dasaweb/bsms-keyboard-boss/Fotos_web/1ac2ef55-5758-45f8-84bb-78c7f2ab67ff.jpg

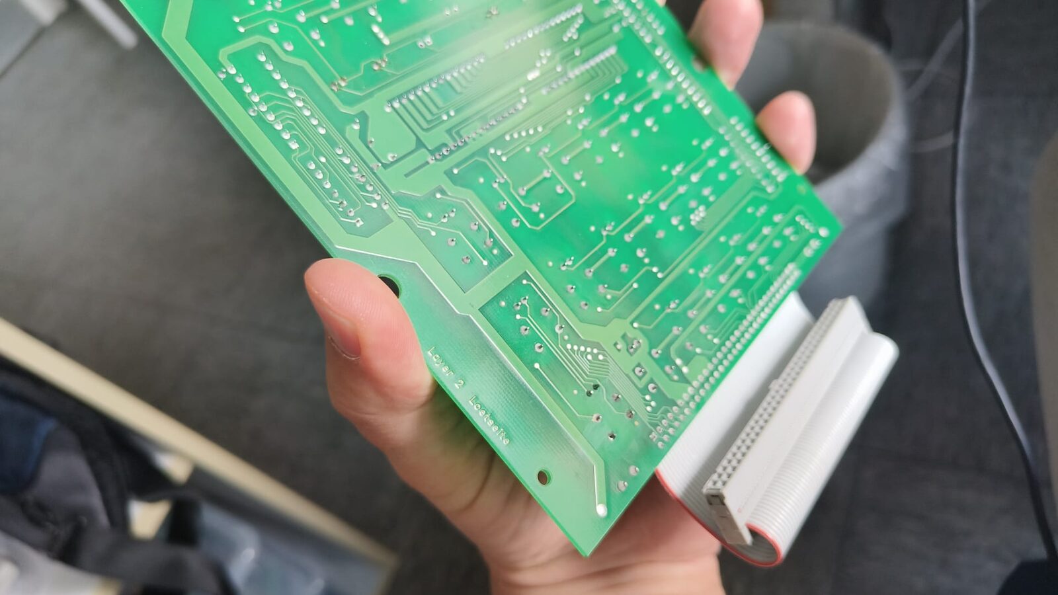
Fotos_web/1ac2ef55-5758-45f8-84bb-78c7f2ab67ff.jpg
