dasaweb/bsms-keyboard-boss/Fotos_web/9411572f-5840-410c-b5de-231dd120ea05.jpg

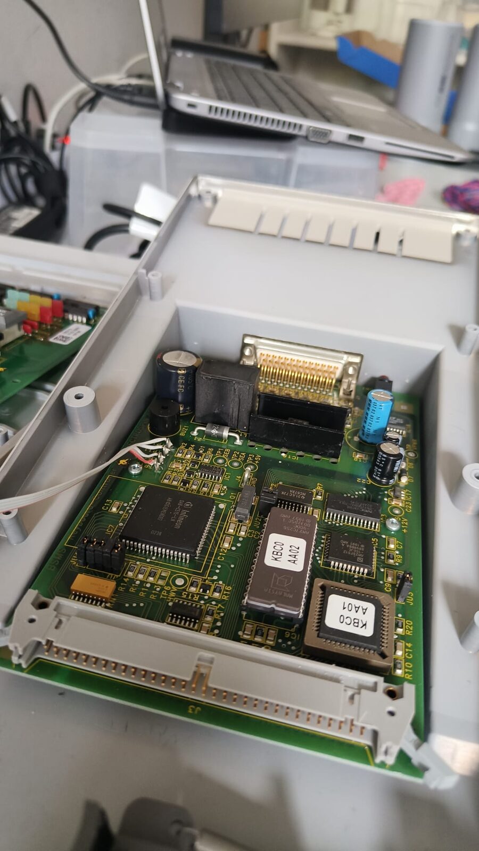
Fotos_web/9411572f-5840-410c-b5de-231dd120ea05.jpg
