dasaweb/bsms-keyboard-boss/Fotos_web/09424705-de8c-4f96-9400-b07d579664a1.jpg

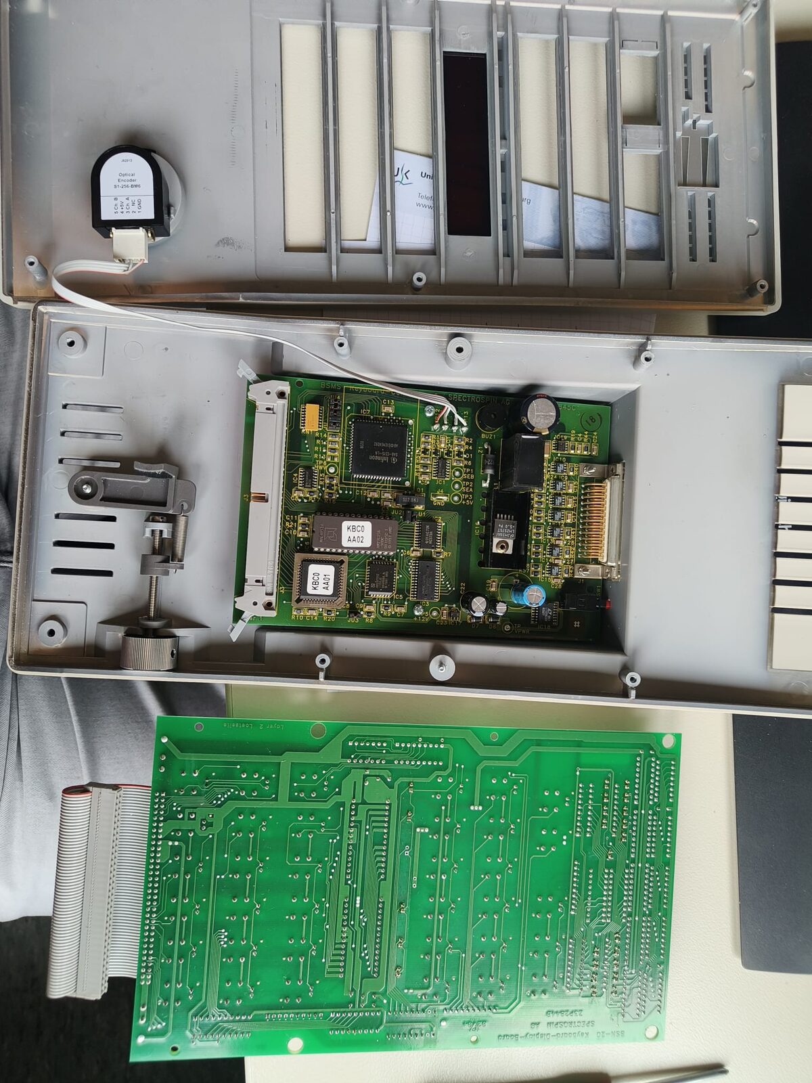
Fotos_web/09424705-de8c-4f96-9400-b07d579664a1.jpg
