dasaweb/bsms-keyboard-boss/Fotos_web/IMG20261009131949.jpg

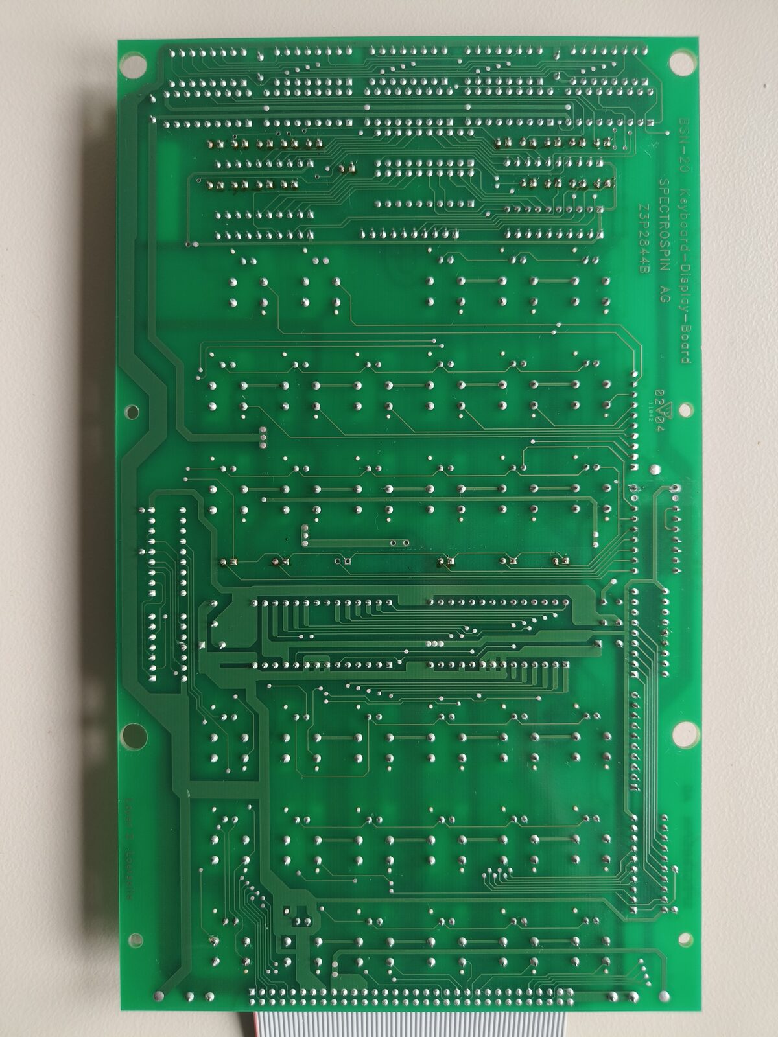
Fotos_web/IMG20261009131949.jpg
