dasaweb/bsms-keyboard-boss/Fotos_web/IMG20261009131957.jpg

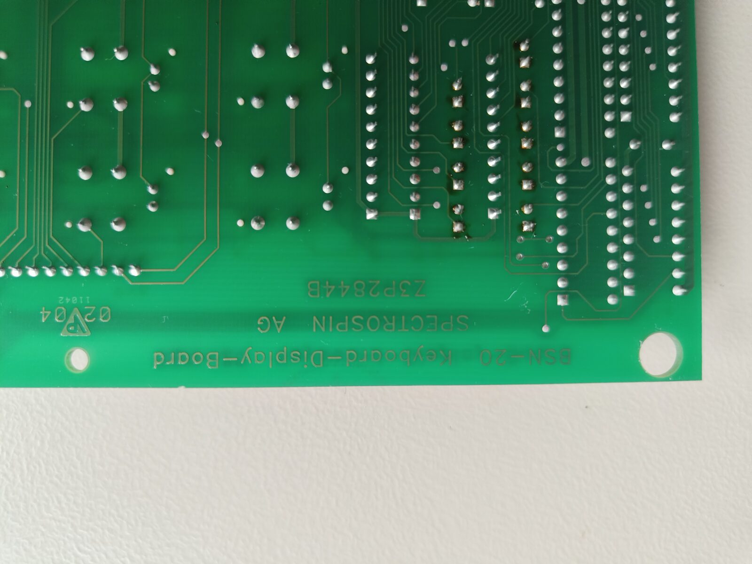
Fotos_web/IMG20261009131957.jpg
