dasaweb/bsms-keyboard-boss/Fotos_web/IMG20261009132025.jpg

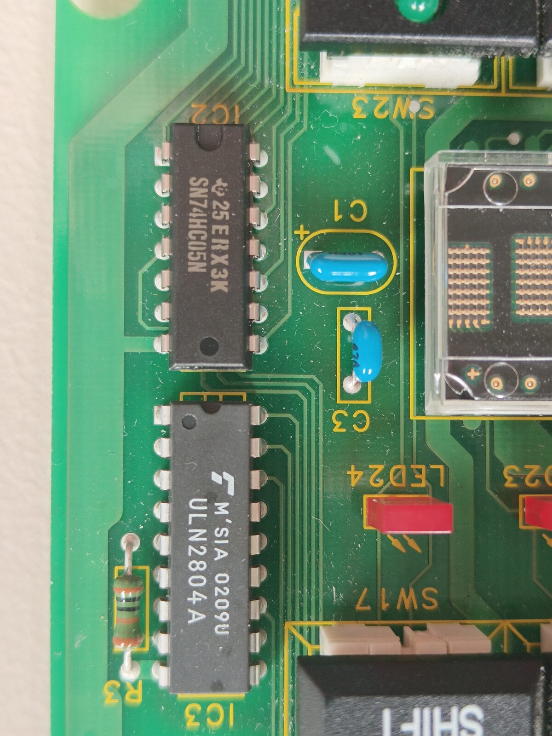
Fotos_web/IMG20261009132025.jpg
