dasaweb/bsms-keyboard-boss/Fotos_web/IMG20261009132038.jpg

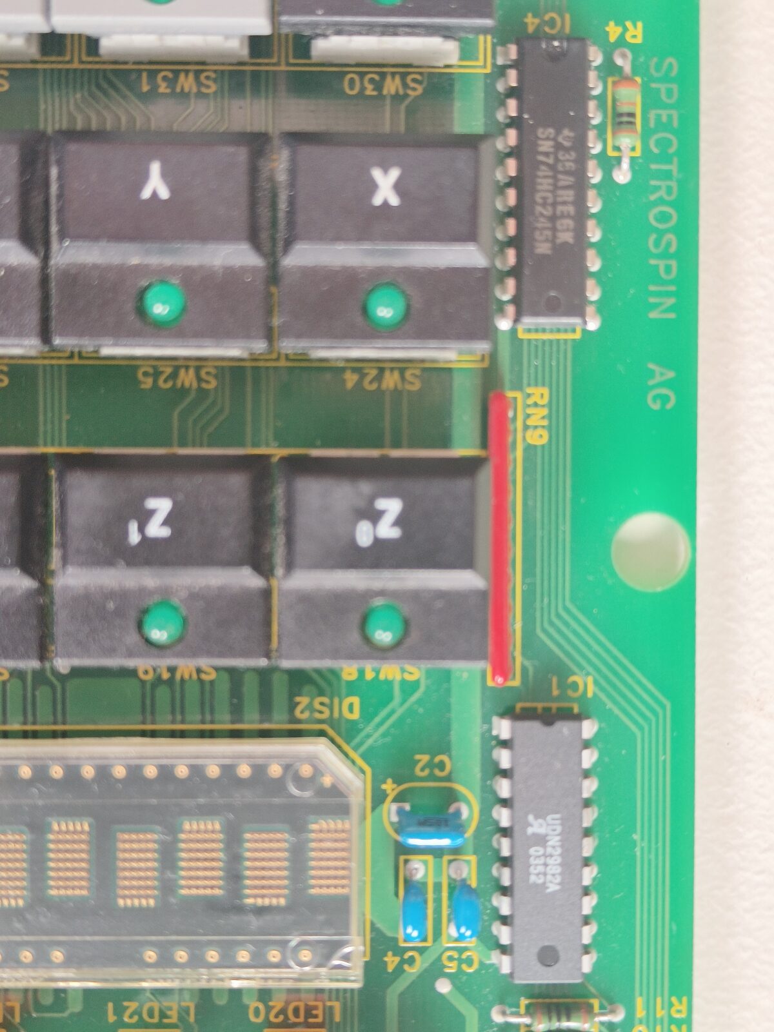
Fotos_web/IMG20261009132038.jpg
