dasaweb/bsms-keyboard-boss/Fotos_web/IMG20261009132052.jpg

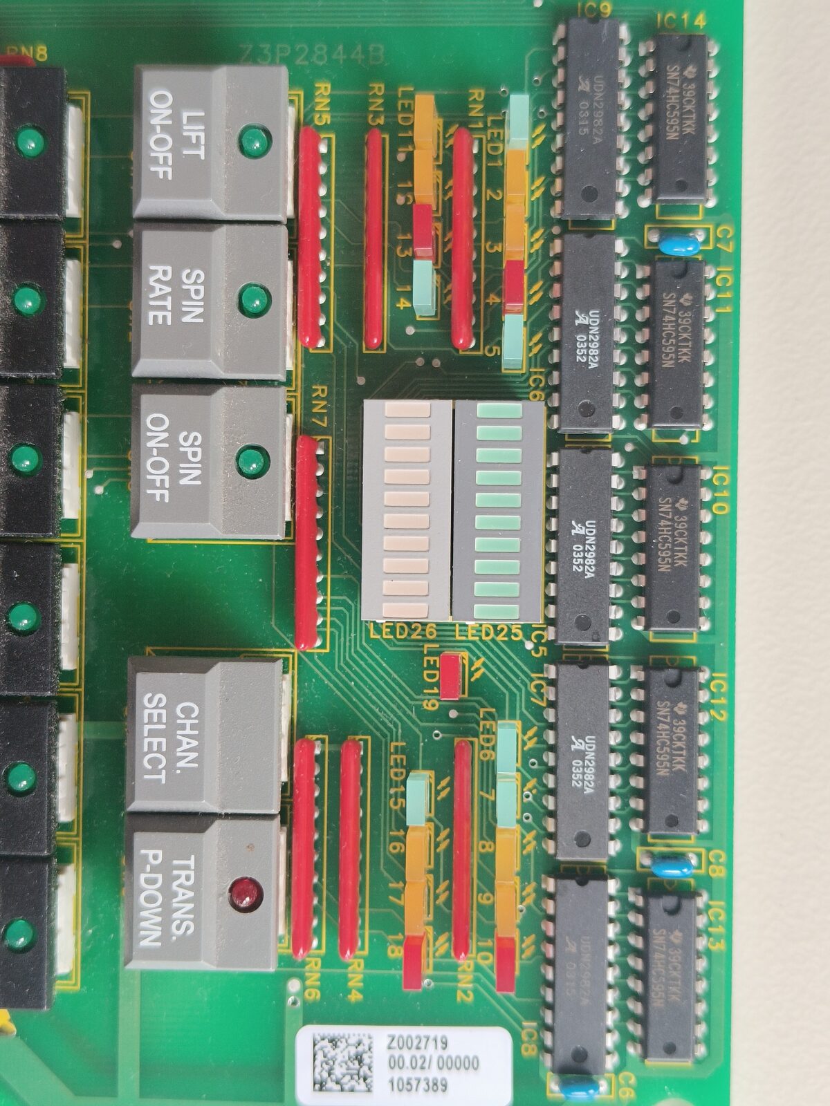
Fotos_web/IMG20261009132052.jpg
