dasaweb/bsms-keyboard-boss/Fotos_web/IMG20261009132102.jpg

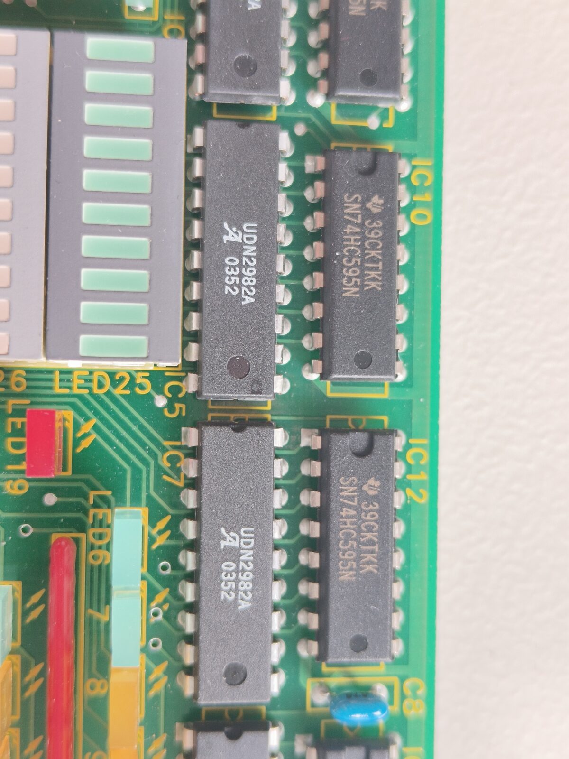
Fotos_web/IMG20261009132102.jpg
