dasaweb/bsms-keyboard-boss/Fotos_web/IMG20261009132112.jpg

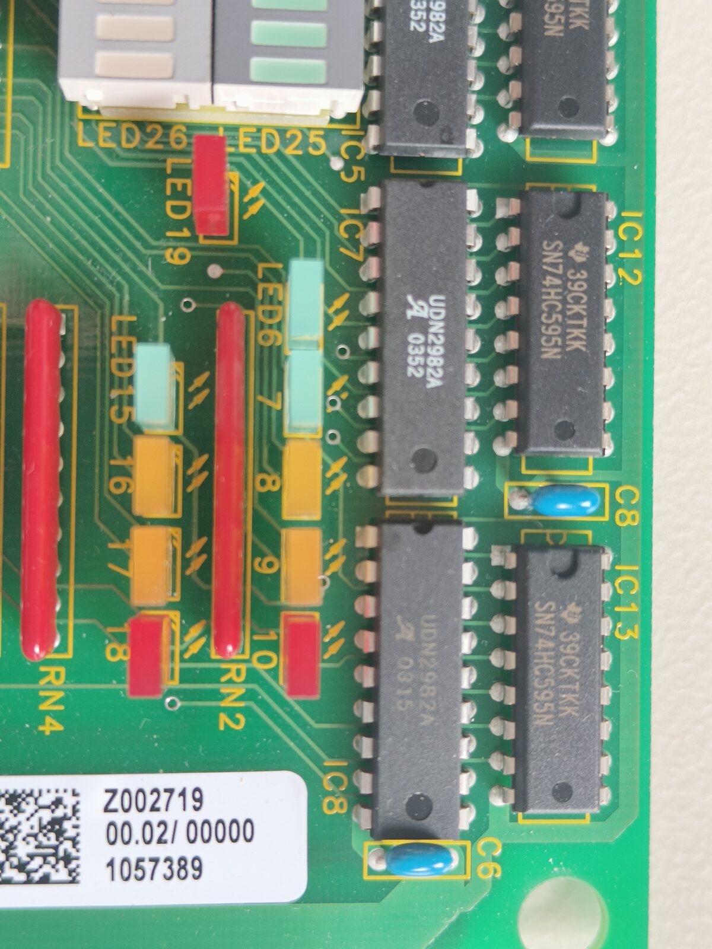
Fotos_web/IMG20261009132112.jpg
