dasaweb/bsms-keyboard-boss/Fotos_web/IMG20261009132202.jpg

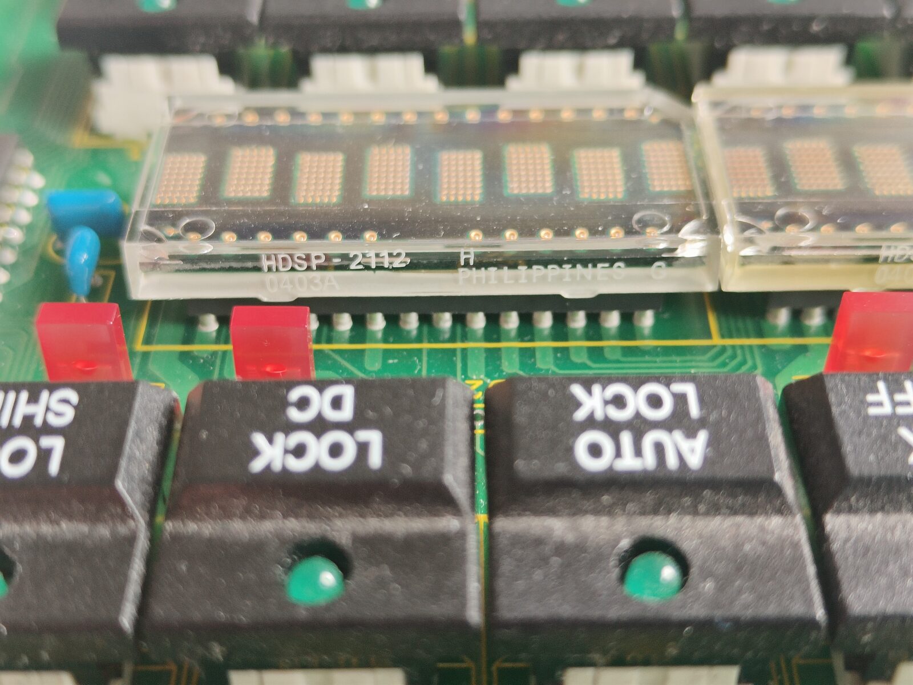
Fotos_web/IMG20261009132202.jpg
