dasaweb/bsms-keyboard-boss/Fotos_web/IMG20261009132218.jpg

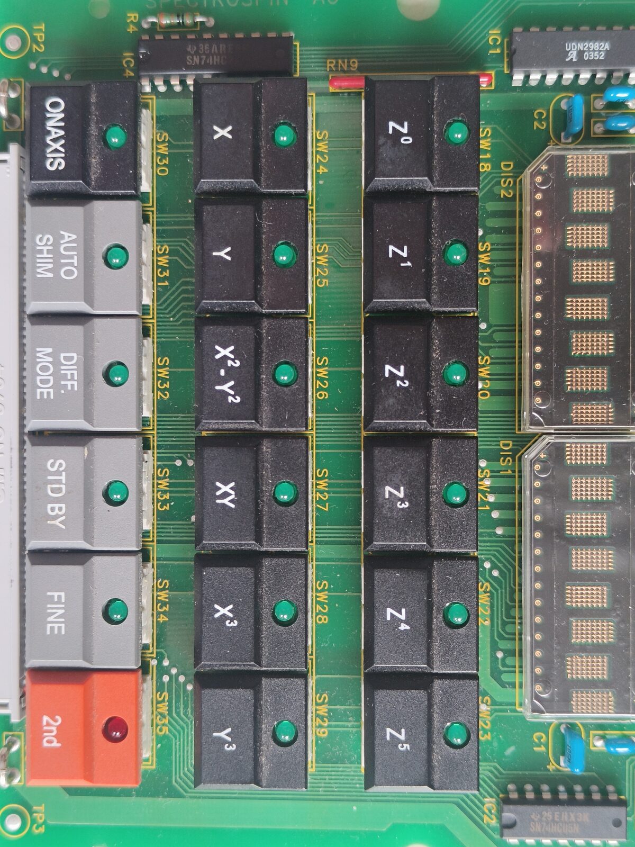
Fotos_web/IMG20261009132218.jpg
