dasaweb/bsms-keyboard-boss/Fotos_web/IMG20261009132224.jpg

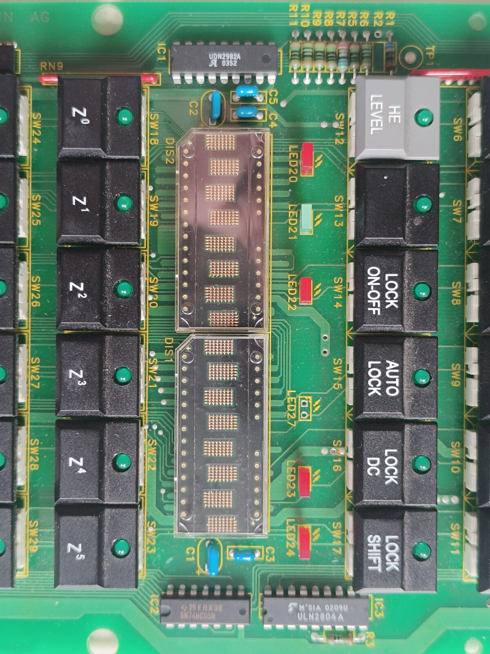
Fotos_web/IMG20261009132224.jpg
