dasaweb/bsms-keyboard-boss/Fotos_web/IMG20261009132230.jpg

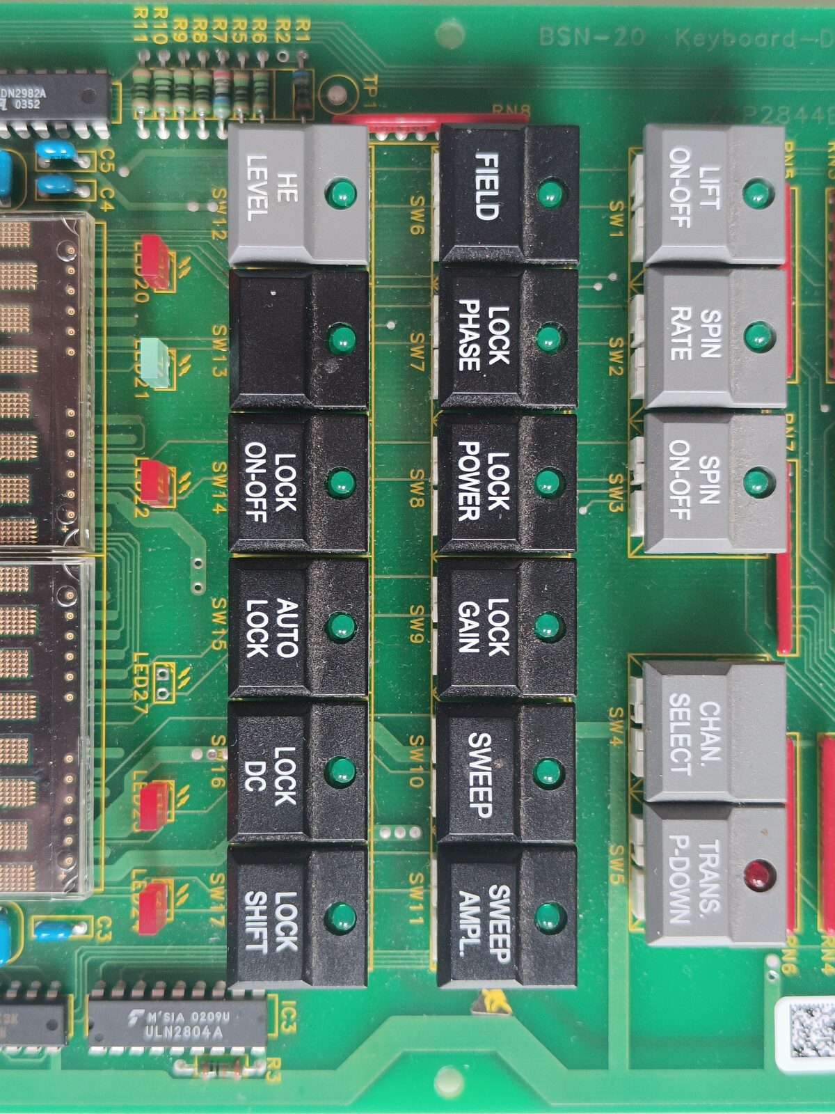
Fotos_web/IMG20261009132230.jpg
