dasaweb/bsms-keyboard-boss/Fotos_web/IMG20261009132234.jpg

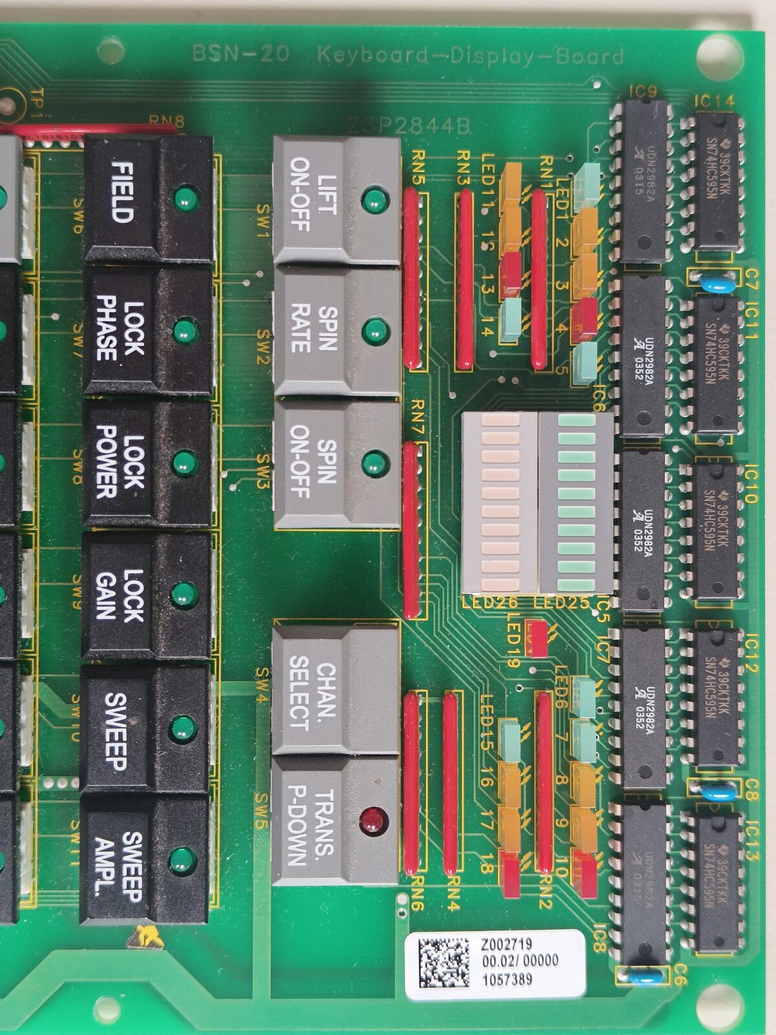
Fotos_web/IMG20261009132234.jpg
