dasaweb/bsms-keyboard-boss/Fotos_web/IMG20261009132243.jpg

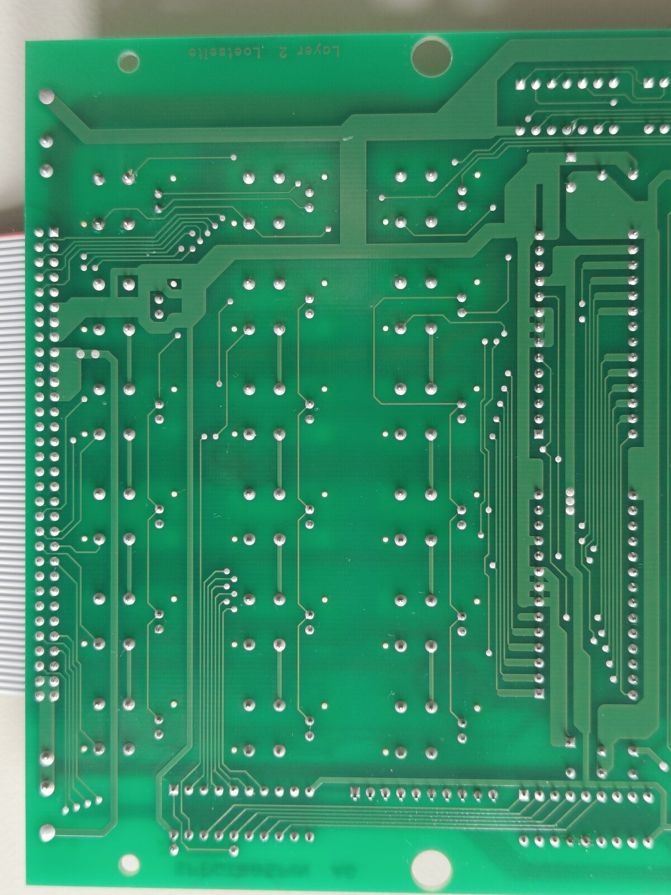
Fotos_web/IMG20261009132243.jpg
