dasaweb/bsms-keyboard-boss/Fotos_web/IMG20261009132250.jpg

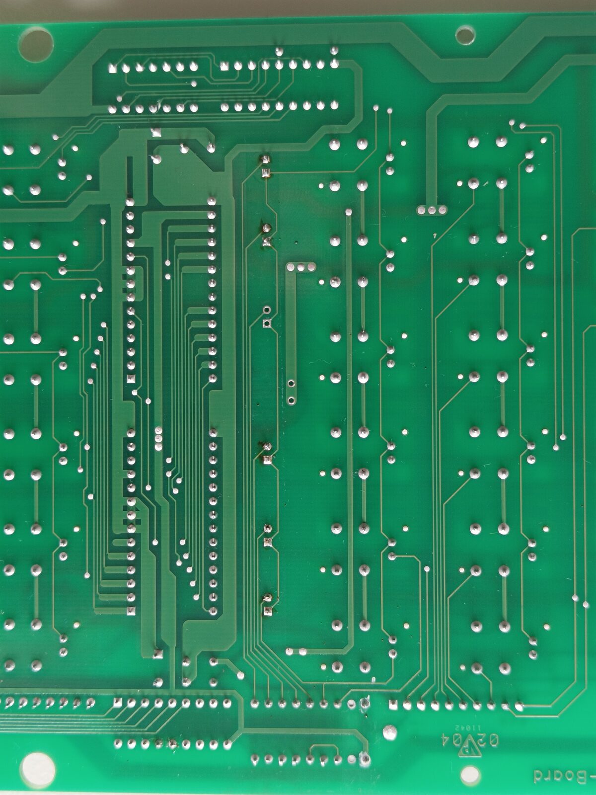
Fotos_web/IMG20261009132250.jpg
