dasaweb/bsms-keyboard-boss/Fotos_web/IMG20261009132254.jpg

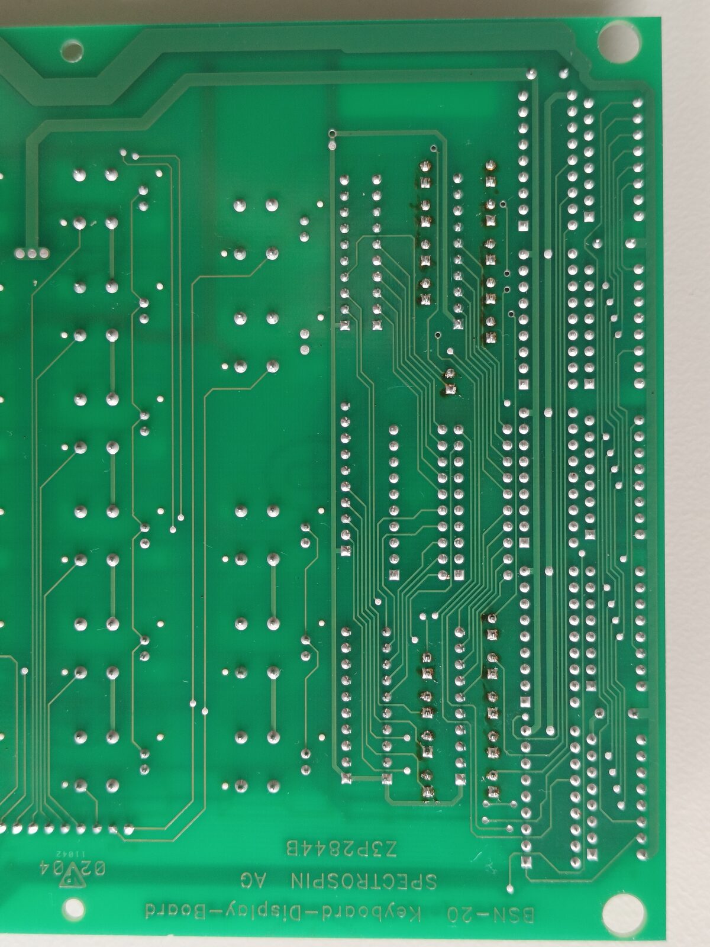
Fotos_web/IMG20261009132254.jpg
