dasaweb/bsms-keyboard-boss/(commit log)

2026-10-14 BSMS Keyboard Boss: Stand nach Reverse-Engineering der Bedienhardware
    Tasten, LEDs, 595-Kette, Displays HDSP-2112 und Encoder laufen mit dem
    Sketch keys auf dem Arduino Mega; GUI, Mess-Tools, Logs und Doku.
    Claude-Session: https://claude.ai/code/session_01SWZHiqev2KKVGkGXzGDefe
2026-10-14 Planung: Option Pico 2 (W) mit 74HCT595 als Pegelwandler/Port-Erweiterung
    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
2026-10-14 README: Bilder, Pinbelegung, Stand und Ausblick
    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
2026-10-15 Varianten der Tastatur (HR-20, BOSS, B-HPCU), HPCU- und Shim-Handbuch, Quellen
    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
2026-10-15 README: Bilderpaare und Fotozeile gleich hoch
    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
2026-10-23 Router-LEDs einzeln schaltbar: P60 ist DLED, nicht +5 V
    - Messung M3: P60 = SER von IC10 (DLED), die 74HC595 hängen an TP3.
    P60 jetzt an D14 statt 5V; alle 40 Kettenpositionen frei schaltbar.
    - keys: LED1-19 einzeln, Bars als Segmente (Pegel oder einzeln),
    CHAN. SELECT = Kanal H/X/Y/Z, TRANS. P-DOWN = Lauflicht,
    neue Befehle R<n>= und B<i>=, Meldungen R/B <hex>.
    - GUI: Router-LEDs und Bar-Segmente klickbar, CHAN. SELECT ohne LED.
    - Neu: Sketch router_brute und tools/router_brute.py (Wackeltest,
    Zufallstest, Einzeltest) mit Logs.
    - CLAUDE.md, PINOUT.md, README.md nachgezogen.
2026-10-23 GUI: Status-LEDs LED20-24 wie auf der Platine verteilt
    LED20-22 gleichmäßig über DIS2, LED27 (leer), LED23, LED24 über DIS1.
2026-10-23 Aderzählung korrigiert (P02-P32 gerade +2), Strommessungen, Layout-Checkliste
    - Die Blöcke G1/G2 steckten am Mega um einen Pin versetzt (P02 auf 5V, D53 leer),
    bestätigt per Durchgang gegen Stecker-Pin 2 und 4. Alle geraden Nummern P02-P32
    in Doku, keys, pin_tracer, router_brute, display_test, led_test korrigiert.
    Status-LED-Zeile = P04, /OE = P28, freie Ader = P26, P02 abgesteckt.
    - Strommessungen: VS max. 0,47 A, 5 V max. 0,34 A, P02 zieht keinen Strom.
    - Rastermaß 2,54 mm, Checkliste für das Layout.
    [display_test.ino, keys.ino, led_test.ino, led_test.py, pin_tracer.ino, pin_tracer.py, router_brute.ino, router_brute.py]
